dlutz52/RTL-Logic-Gates-Solder-Kit/README.md

# RTL-Logic-Gates-Solder-Kit
PCB of various logic gates inspired by Ben Eater and implemented as a solder kit. It is a bit over the top in the power supply section, 
but it is my first design as a newbie and was good experience - especially since it took seven versions to get it right...
