dlutz52/RTL-Logic-Gates-Solder-Kit/rtl-logic-gates-c2032-smd_final.kicad_pcb

## KiCad design rtl-logic-gates-c2032-smd_final.kicad_pcb (2025-08-17)

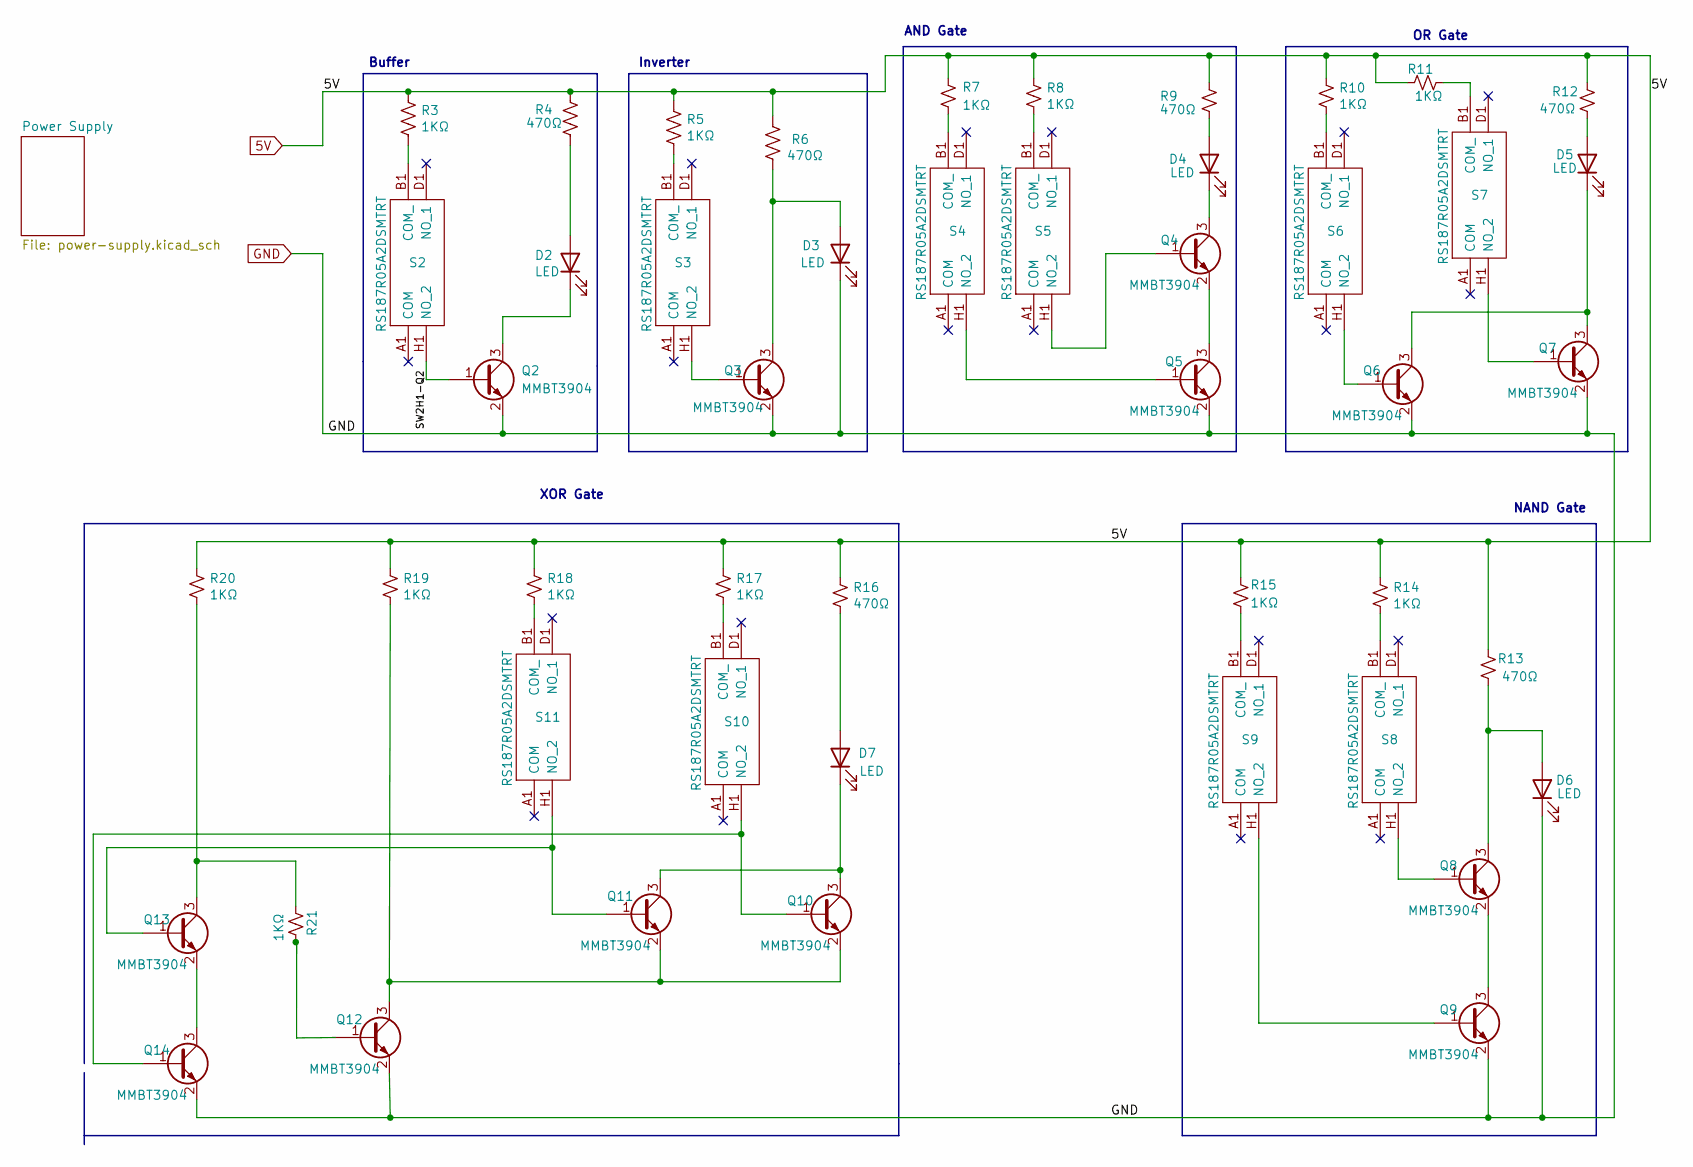
[picture p1: schematic rtl-logic-gates-c2032-smd_final.kicad_sch, ${project_name}]

Parts:
D2, D3, D4, D5, D6, D7: LED; LED_1206_3216Metric_Pad1.42x1.75mm_HandSolder
Q2, Q3, Q4, Q5, Q6, Q7, Q8, Q9, Q10, Q11, Q12, Q13, Q14: MMBT3904; SOT-23
R3, R5, R7, R8, R10, R11, R14, R15, R17, R18, R19, R20, R21: 1KΩ; R_1206_3216Metric_Pad1.30x1.75mm_HandSolder
R4, R6, R9, R12, R13, R16: 470Ω; R_1206_3216Metric_Pad1.30x1.75mm_HandSolder
S2, S3, S4, S5, S6, S7, S8, S9, S10, S11: RS187R05A2DSMTRT; Manufacturer_Part_Number RS187R05A2DSMTRT; Mouser Part Number 611-RS187R05A2DSMTRT

Connections:
5V: R3.1, R4.1, R5.1, R6.1, R7.1, R8.1, R9.2, R10.1, R11.1, R12.1, R13.2, R14.1, R15.1, R16.1, R17.1, R18.1, R19.1, R20.1; also elsewhere on the board
/SW2H1-Q2: Q2.1 (B), S2.H1 (NO_2)
GND: D3.1 (K), D6.1 (K), Q2.2 (E), Q3.2 (E), Q5.2 (E), Q6.2 (E), Q7.2 (E), Q9.2 (E), Q12.2 (E), Q14.2 (E); also elsewhere on the board
unnamed: D2.1 (K), Q2.3 (C)
unnamed: D2.2 (A), R4.2
unnamed: D4.1 (K), Q4.3 (C)
unnamed: D4.2 (A), R9.1
unnamed: D5.1 (K), Q6.3 (C), Q7.3 (C)
unnamed: D5.2 (A), R12.2
unnamed: D6.2 (A), Q8.3 (C), R13.1
unnamed: D7.1 (K), Q10.3 (C), Q11.3 (C)
unnamed: D7.2 (A), R16.2
unnamed: Q3.1 (B), S3.H1 (NO_2)
unnamed: D3.2 (A), Q3.3 (C), R6.2
unnamed: Q4.1 (B), S5.H1 (NO_2)
unnamed: Q4.2 (E), Q5.3 (C)
unnamed: Q5.1 (B), S4.H1 (NO_2)
unnamed: Q6.1 (B), S6.H1 (NO_2)
unnamed: Q7.1 (B), S7.H1 (NO_2)
unnamed: Q8.1 (B), S8.H1 (NO_2)
unnamed: Q8.2 (E), Q9.3 (C)
unnamed: Q9.1 (B), S9.H1 (NO_2)
unnamed: Q10.1 (B), Q14.1 (B), S10.H1 (NO_2)
unnamed: Q10.2 (E), Q11.2 (E), Q12.3 (C), R19.2
unnamed: Q11.1 (B), Q13.1 (B), S11.H1 (NO_2)
unnamed: Q12.1 (B), R21.2
unnamed: Q13.2 (E), Q14.3 (C)
unnamed: Q13.3 (C), R20.2, R21.1
unnamed: R3.2, S2.B1 (COM_)
unnamed: R5.2, S3.B1 (COM_)
unnamed: R7.2, S4.B1 (COM_)
unnamed: R8.2, S5.B1 (COM_)
unnamed: R10.2, S6.B1 (COM_)
unnamed: R11.2, S7.B1 (COM_)
unnamed: R14.2, S8.B1 (COM_)
unnamed: R15.2, S9.B1 (COM_)
unnamed: R17.2, S10.B1 (COM_)
unnamed: R18.2, S11.B1 (COM_)

Notes on the sheet:
OR Gate
Inverter
NAND Gate
Buffer
AND Gate
XOR Gate

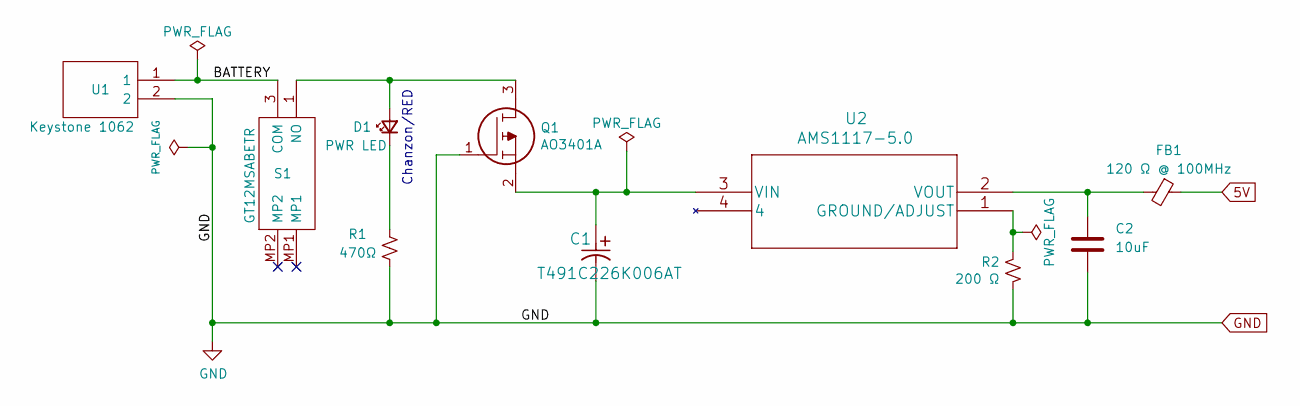
[picture p2: schematic power-supply.kicad_sch, ${project_name}]

Parts:
C1: T491C226K006AT; Digikey Part Number 399-3742-1-ND
C2: 10uF; C_1206_3216Metric_Pad1.33x1.80mm_HandSolder
D1: PWR LED; LED_1206_3216Metric_Pad1.42x1.75mm_HandSolder
FB1: 120 Ω @ 100MHz; R_1206_3216Metric_Pad1.30x1.75mm_HandSolder
Q1: AO3401A; SOT95P280X125-3N; Manufacturer_Part_Number AO3401A
R1: 470Ω; R_1206_3216Metric_Pad1.30x1.75mm_HandSolder
R2: 200 Ω; R_1206_3216Metric_Pad1.30x1.75mm_HandSolder
S1: GT12MSABETR; Manufacturer_Part_Number GT12MSABETR; Mouser Part Number 611-GT12MSABETR
U1: Keystone 1062; 1062TR; Manufacturer_Part_Number 1062TR; Mouser Part Number 534-1062TR
U2: AMS1117-5.0

Connections:
5V: FB1.1; also elsewhere on the board
/Power Supply/BATTERY: S1.3 (COM), U1.1
GND: C1.2, C2.2, Q1.1, R1.2, R2.2, U1.2; also elsewhere on the board
unnamed: C1.1, Q1.2, U2.3 (VIN)
unnamed: C2.1, FB1.2, U2.2 (VOUT)
unnamed: D1.1 (K), R1.1
unnamed: D1.2 (A), Q1.3, S1.1 (NO)
unnamed: R2.1, U2.1 (GROUND/ADJUST)

Notes on the sheet:
Chanzon/RED

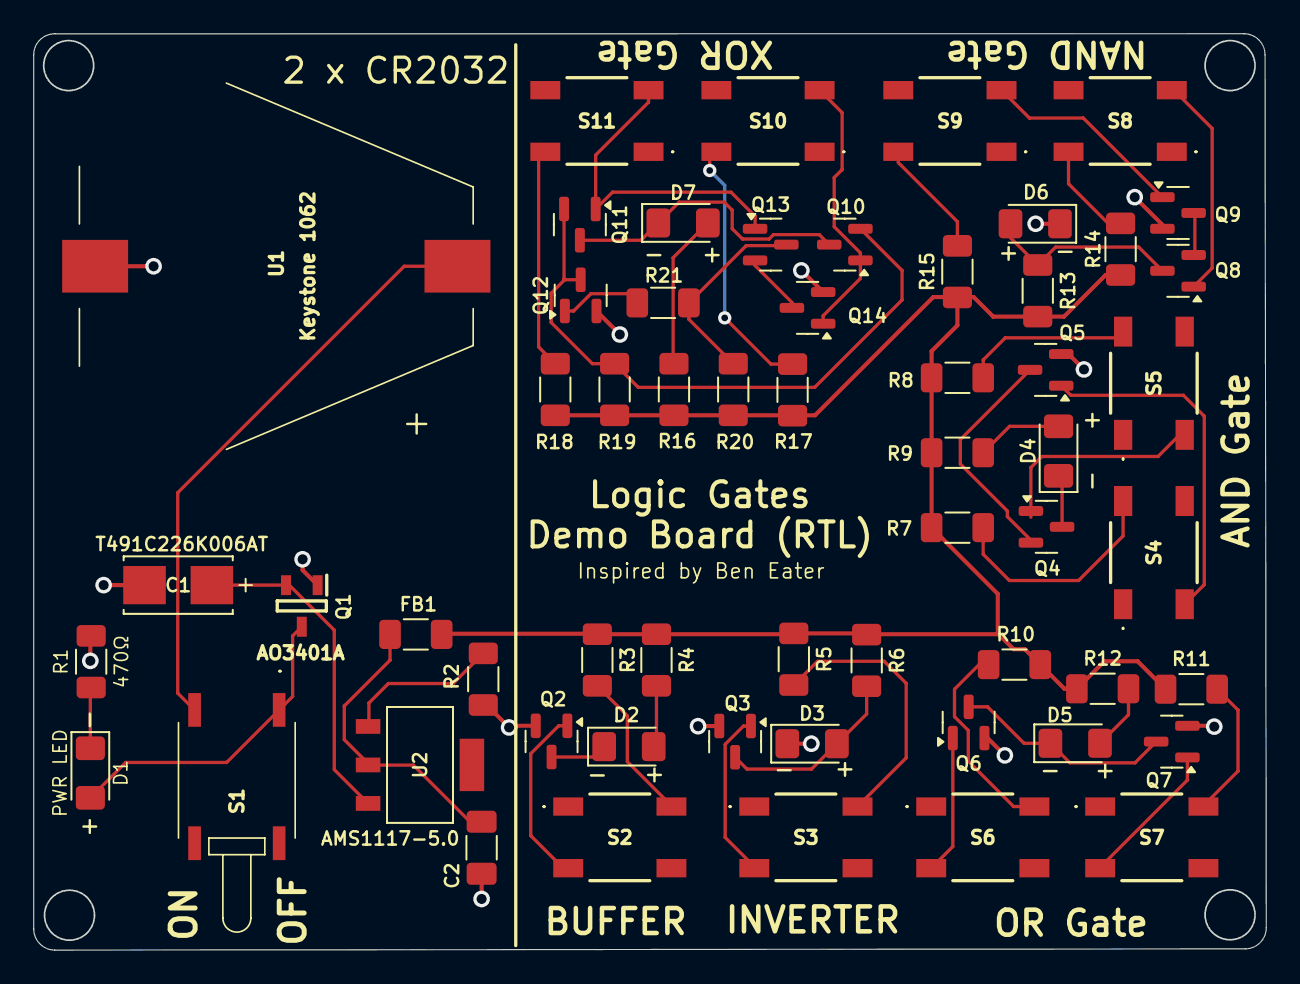
[picture p3: board rtl-logic-gates-c2032-smd_final.kicad_pcb from above]

Board: 2 copper layers, 74.0 x 55.0 mm, 60 parts (2 on the bottom side), 44 nets.

Other parts of the board:
G1: LOGO; Lutzcraft_logo_1125DPI
REF2: KiCad-Logo2_12mm_SilkScreen
