dlutz52/RTL-Logic-Gates-Solder-Kit/(commit log)

2023-03-02 First and only commit
    [power-supply.kicad_sch, rtl-logic-gates-c2032-smd_final.kicad_pcb, rtl-logic-gates-c2032-smd_final.kicad_sch]
2024-10-01 Saved in Kicad v7 and added .gitignore
    [power-supply.kicad_sch, rtl-logic-gates-c2032-smd_final.kicad_pcb, rtl-logic-gates-c2032-smd_final.kicad_sch]
2024-10-01 Saved in Kicad v8 and added archivew directory to .gitignore
    [power-supply.kicad_sch, rtl-logic-gates-c2032-smd_final.kicad_pcb, rtl-logic-gates-c2032-smd_final.kicad_sch]
2024-10-01 Saved with Kicad v8 and fixed footprints to clear all DRC errors/warnings
    [rtl-logic-gates-c2032-smd_final.kicad_pcb]
2025-08-17 Upgraded project to KiCad 9.0.3.
    [power-supply.kicad_sch, rtl-logic-gates-c2032-smd_final.kicad_pcb, rtl-logic-gates-c2032-smd_final.kicad_sch]
