dlutz52/RTL-Logic-Gates-Solder-Kit/(notices)

Notices in the files:
parts and their libraries:
Copyright 2021 Accelerated Designs. All rights reserved.
